mircotoll01/butterfly-SOA-driver/hardware/SOA-driver.kicad_pcb

## KiCad design hardware/SOA-driver.kicad_pcb (2025-08-11)

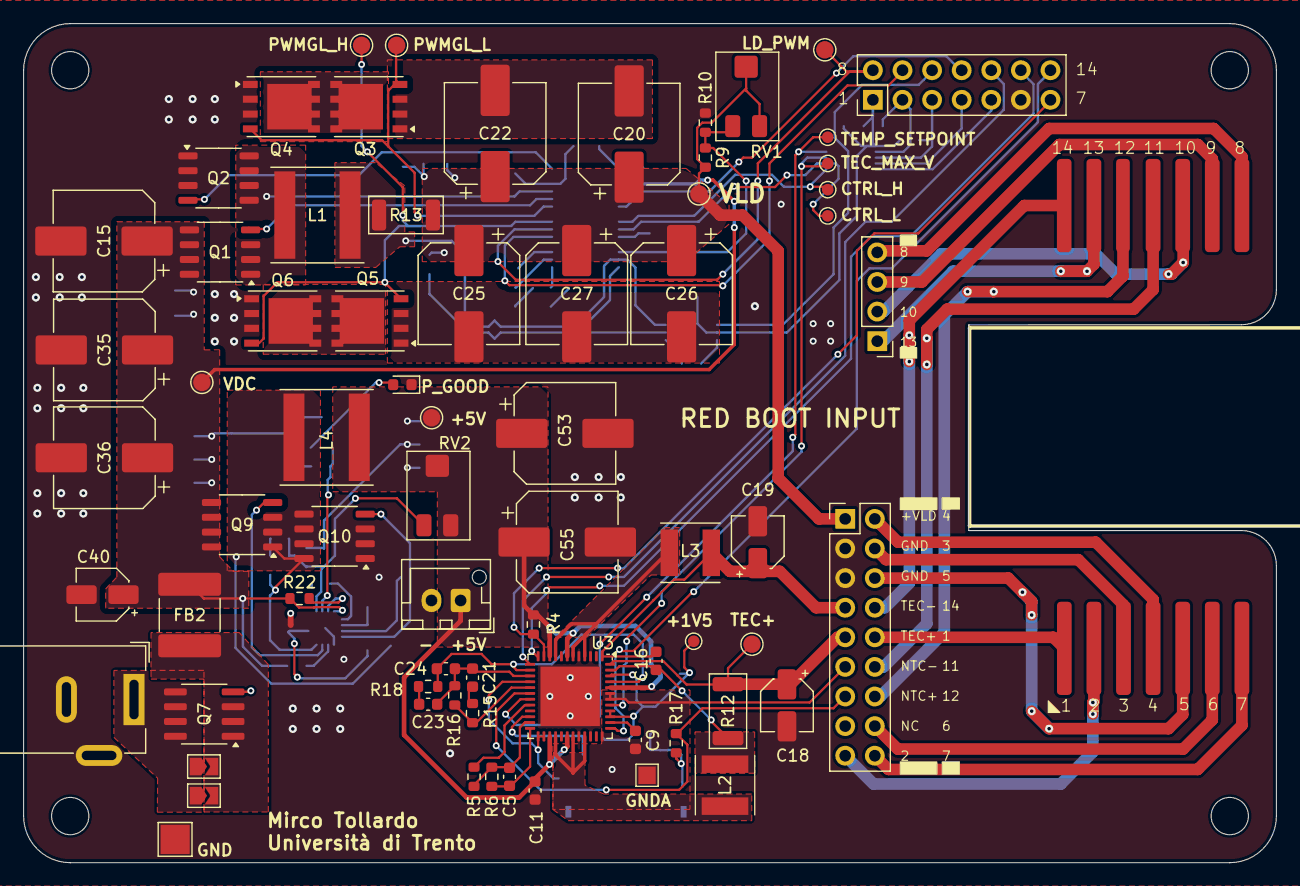
[picture p3: board SOA-driver.kicad_pcb from above]

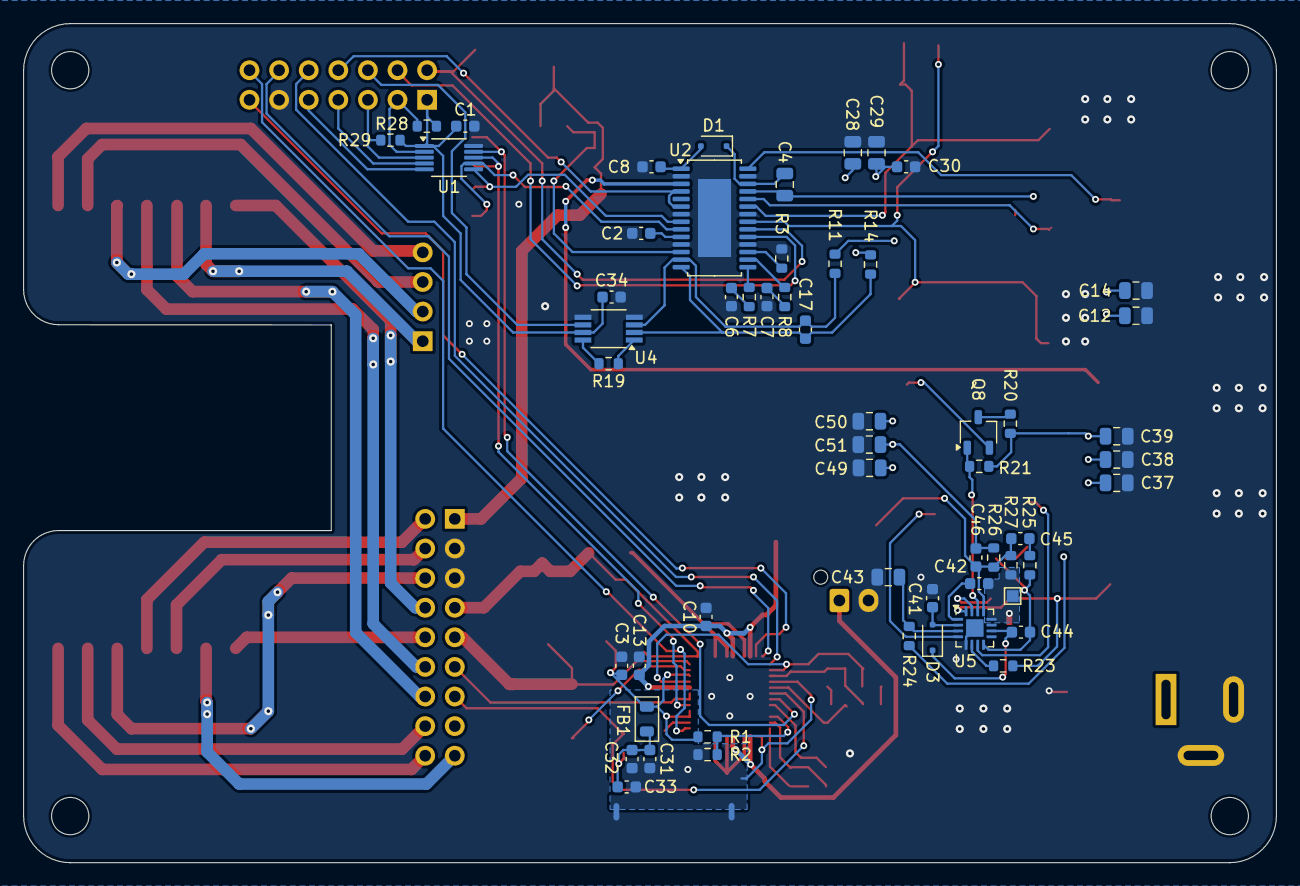
[picture p4: board SOA-driver.kicad_pcb from below]

Board: 2 copper layers, 107.5 x 72.0 mm, 136 parts (59 on the bottom side), 92 nets.

Parts:
C1, C3, C32, C34, C44, C45, C46: 100n; C_0603_1608Metric
C2, C9, C30, C33: 10n; C_0603_1608Metric
C4, C14, C29, C39, C43, C49: 100n; C_0805_2012Metric
C5, C31: 1u; C_0603_1608Metric
C6, C7: 2.2n; C_0603_1608Metric
C8, C10: 22u; C_0603_1608Metric
C11, C13, C23: 10u; C_0603_1608Metric
C12, C28, C38, C50: 1u; C_0805_2012Metric
C15, C20, C22, C25, C26, C27, C53, C55: 330u; CP_Elec_8x10.5
C16, C41, C42: 4u7; C_0603_1608Metric
C17: 33n; C_0603_1608Metric
C18, C19, C40: 1u; CP_Elec_4x5.4
C21, C24: 470n; C_0603_1608Metric
C35, C36: 220u; CP_Elec_8x10.5
C37, C51: 10u; C_0805_2012Metric
D1, D3: BAT54; D_SOD-323F
D2: LED; LED_0603_1608Metric
FB1: 110R; Ferrite_0805_2012Metric
FB2: 100; C_2220_5750Metric_Pad1.97x5.40mm_HandSolder
H1, H2, H3, H4: MountingHole; MountingHole_3.2mm_M3_ISO7380
J1: BASYS3; PinHeader_2x07_P2.54mm_Vertical
J2: BUTTERFLY; Butterfly_14pins_SMD
J3: Barrel_Jack_Switch; BarrelJack_Wuerth_6941xx301002
J4: SELECTOR; PinHeader_2x09_P2.54mm_Vertical
J5: SELECTOR_2; PinHeader_1x04_P2.54mm_Vertical
J6: 5V EXT; JST_XH_B2B-XH-AM_1x02_P2.50mm_Vertical
JP1, JP2: SolderJumper_2_Open; SolderJumper-2_P1.3mm_Open_TrianglePad1.0x1.5mm
L1, L4: 22u; L_Taiyo-Yuden_NR-80xx
L2, L3: 3u3; L_Taiyo-Yuden_NR-50xx
NT1, NT2, NT3: NetTie_2; NetTie-2_SMD_Pad0.5mm
Q1, Q2, Q9, Q10: RJK0355DSP; SOP-8_3.9x4.9mm_P1.27mm
Q3, Q4, Q5, Q6: SiRC18DP; PowerPAK_SO-8_Single
Q7: DMP3037LSS-13; SOIC-8_3.9x4.9mm_P1.27mm
Q8: 2N7002; TSOT-23
R1: 69.8k; R_0603_1608Metric
R2, R5: 20k; R_0603_1608Metric
R3: 40.2k; R_0603_1608Metric
R4, R10, R27, R29: 1k; R_0603_1608Metric
R6: 80.6k; R_0603_1608Metric
R7, R8: 806k; R_0603_1608Metric
R9, R20: 2k2; R_0603_1608Metric
R11, R14, R28: 10; R_0603_1608Metric
R12: 200m; R_2010_5025Metric
R13: 50m; R_2010_5025Metric
R15: 22k; R_0603_1608Metric
R16: 1M; R_0603_1608Metric
R17, R21, R22: 10k; R_0603_1608Metric
R18: 100k; R_0603_1608Metric
R19: 11K 0.1%; R_0603_1608Metric
R23: 100k 1%; R_0603_1608Metric
R24, R25: R_Small; R_0603_1608Metric
R26: 5k6; R_0603_1608Metric
RV1: 1k; Potentiometer_Bourns_3224X_Vertical
RV2: 10k; Potentiometer_Bourns_3224X_Vertical
TP1, TP8, TP9, TP10, TP11: TestPoint; TestPoint_Pad_D1.0mm
TP2: TestPoint; TestPoint_Pad_1.5x1.5mm
TP3, TP4, TP5, TP6, TP7, TP14, TP15: TestPoint; TestPoint_Pad_D1.5mm
TP12: TestPoint; TestPoint_Pad_2.5x2.5mm
TP13: TestPoint; TestPoint_Pad_1.0x1.0mm
U1: MCP4728; MSOP-10_3x3mm_P0.5mm
U2: LT3743; TSSOP-28-1EP_4.4x9.7mm_P0.65mm_EP2.85x6.7mm
U3: MAX1978; TQFN-48-1EP_7x7mm_P0.5mm_EP5.1x5.1mm
U4: INA333xxDGK; VSSOP-8_3.0x3.0mm_P0.65mm
U5: MIC2101; HVQFN-16-1EP_3x3mm_P0.5mm_EP1.5x1.5mm

Connections:
+1V5: C3.2, FB1.1, R1.1, TP1.1, U3.39 (MAXIP), U3.40 (MAXIN), U3.46 (REF)
+3V3: C1.1, C34.1, J1.1, R28.2, R29.2, U1.1 (VDD), U4.7 (V+)
+5V: C10.1, C11.1, C13.1, C46.2, C49.1, C50.1, C51.1, C53.1, C55.1, J6.1, L4.2, R4.1, R26.2, RV2.2, RV2.3, TP14.1, U3.7 (PVDD2), U3.10 (PVDD2), U3.27 (PVDD1), U3.30 (PVDD1), U3.44 (VDD)
/5V DCDC converter/DH: Q9.4 (G), U5.7 (DH)
/5V DCDC converter/DL: Q10.4 (G), U5.4 (DL)
/5V DCDC converter/FB: C45.1, C46.1, R26.1, R27.2, RV2.1, U5.13 (FB)
/SOA Driver/LD: C20.1, C22.1, C25.1, C26.1, C27.1, C28.1, C29.1, C30.1, J4.1, R9.2, R13.2, R14.2, RV1.2, RV1.3, TP4.1
/SOA Driver/NTC+: J4.13, R17.2, U3.18 (FB-)
/SOA Driver/PWMGH: Q5.4 (G), Q6.4 (G), TP5.1, U2.21 (PWMGH)
/SOA Driver/PWMGL: Q3.4 (G), Q4.4 (G), TP6.1, U2.23 (PWMGL)
/SOA Driver/Pin_1: J2.1, J4.10
/SOA Driver/Pin_2: J2.2, J4.17
/SOA Driver/Pin_3: J2.3, J4.4
/SOA Driver/Pin_4: J2.4, J4.2
/SOA Driver/Pin_5: J2.5, J4.6
/SOA Driver/Pin_6: J2.6, J4.16
/SOA Driver/Pin_7: J2.7, J4.18
/SOA Driver/Pin_8: J2.8, J5.4
/SOA Driver/Pin_9: J2.9, J5.3
/SOA Driver/Pin_10: J2.10, J5.2
/SOA Driver/Pin_11: J2.11, J4.12
/SOA Driver/Pin_12: J2.12, J4.14
/SOA Driver/Pin_13: J2.13, J5.1
/SOA Driver/Pin_14: J2.14, J4.8
/SOA Driver/SENSE+: C17.2, R11.1, U2.13 (SENSE+), U4.3 (+)
/SOA Driver/SENSE-: C17.1, R14.1, U2.14 (SENSE-), U4.2 (-)
/SOA Driver/SW: C4.2, L1.1, Q1.1 (S), Q1.2 (S), Q1.3 (S), Q2.5 (D), Q2.6 (D), Q2.7 (D), Q2.8 (D), U2.25 (SW)
/SOA Driver/TEC+: C18.1, J4.9, R12.2, TP3.1, U3.48 (OS1)
/SOA Driver/TEC-: C16.2, C19.1, J4.7, L3.2, U3.1 (OS2)
/TEC controller/1V5ADC: C31.1, C32.1, C33.1, FB1.2, R17.1
/TEC controller/BFB-: R5.2, U3.20 (BFB-)
/TEC controller/INT-: C21.1, C23.2, C24.1, R16.2, U3.15 (INT-)
/TEC controller/INTOUT: C24.2, R18.1, U3.14 (INTOUT), U3.45 (CTLI)
/TEC controller/MAXV_DAC: TP10.1, U1.8 (VOUTC), U3.41 (MAXV)
/TEC controller/TTEC_SETPOINT_DAC: TP11.1, U1.9 (VOUTD), U3.19 (FB+)
CTRL_H_DAC: TP8.1, U1.6 (VOUTA), U2.8 (CTRL_H)
CTRL_L_DAC: TP9.1, U1.7 (VOUTB), U2.9 (CTRL_L)
GND: C1.2, C2.1, C3.1, C6.2, C7.1, C8.1, C10.2, C11.2, C12.2, C13.2, C14.2, C15.2, C18.2, C19.2, C28.2, C29.2, C30.2, C34.2, C35.2, C36.2, C37.2, C38.2, C39.2, C40.2, C41.2, C43.1, C49.2, C50.2, C51.2, C53.2, C55.2, D2.1 (K), J1.11, J3.2, J3.3, J4.3, J4.5, J6.2, NT1.1, NT2.1, NT3.1, Q2.1 (S), Q2.2 (S), Q2.3 (S), Q4.1 (S), Q4.2 (S), Q4.3 (S), Q6.1 (S), Q6.2 (S), Q6.3 (S), Q7.4 (G), Q10.1 (S), Q10.2 (S), Q10.3 (S), R3.1, R10.1, TP12.1, U1.10 (VSS), U2.2 (GND), U2.7 (GND), U2.11 (GND), U2.18 (SYNC), U2.22 (GND), U2.27 (GND), U2.29 (GND), U3.3 (PGND2), U3.5 (PGND2), U3.32 (PGND1), U3.34 (PGND1), U3.49 (EP), U4.4 (V-), U4.5 (Ref), U5.5 (PGND), U5.17 (EP)
GND1: C42.2, NT2.2, R27.1, TP13.1, U5.12 (AGND)
GNDA: C9.2, C31.2, C32.2, C33.2, NT1.2, NT3.2, R2.2, TP2.1, U3.16 (AGND), U3.25 (AGND), U3.26 (AGND), U3.36 (FREQ), U3.42 (AGND), U3.43 (AGND)
ILD_MON: J1.6, U4.6
ITEC_MON: J1.14, U3.37 (ITEC)
LD_EN: J1.8, U2.4 (EN/UVLO), U2.6 (CTRL_T)
LD_MODULATION: TP7.1, U2.20 (PWM)
unnamed: C6.1, R7.2
unnamed: C7.2, R8.2
unnamed: C20.2, C22.2, Q3.1 (S), Q3.2 (S), Q3.3 (S)
unnamed: C21.2, R15.2
unnamed: C23.1, R18.2
unnamed: C25.2, C26.2, C27.2, Q5.1 (S), Q5.2 (S), Q5.3 (S)
unnamed: C45.2, R25.1
unnamed: C8.2, D1.2 (A), U2.1 (VCC_INT)
unnamed: C4.1, D1.1 (K), U2.26 (CBOOT)
unnamed: D2.2 (A), Q8.2 (S)
unnamed: C41.1, C42.1, D3.2 (A), U5.1 (VDD), U5.2 (PVDD)
unnamed: C44.2, D3.1 (K), U5.10 (BST)
unnamed: J3.1, JP1.1 (A), JP2.1 (A), Q7.5 (D), Q7.6 (D), Q7.7 (D), Q7.8 (D)
unnamed: FB2.1, JP1.2 (B), JP2.2 (B), Q7.1 (S), Q7.2 (S), Q7.3 (S)
unnamed: L1.2, R11.2, R13.1
unnamed: L2.1, U3.28 (LX1), U3.31 (LX1), U3.33 (LX1)
unnamed: L3.1, U3.4 (LX2), U3.6 (LX2), U3.9 (LX2)
unnamed: Q1.4 (G), U2.24 (HG)
unnamed: Q2.4 (G), U2.28 (LG)
unnamed: Q3.5 (D), Q4.5 (D)
unnamed: Q5.5 (D), Q6.5 (D)
unnamed: Q8.3 (D), R20.1
unnamed: Q8.1 (G), R21.1, U5.14 (PG)
unnamed: R19.1, U4.8 (Rg)
unnamed: R19.2, U4.1 (Rg)
unnamed: R9.1, R10.2, RV1.1, U2.12 (FB)
unnamed: R3.2, U2.17 (RT)
unnamed: C2.2, U2.10 (SS)
unnamed: R8.1, U2.16 (VCH)
unnamed: R7.1, U2.15 (VCL)
unnamed: R1.2, R2.1, U3.22 (AIN+)
unnamed: C5.1, R5.1, R6.1, U3.23 (AIN-)
unnamed: C5.2, R6.2, U3.24 (AOUT)
unnamed: C9.1, U3.38 (COMP)
unnamed: C16.1, L2.2, R12.1, U3.47 (CS)
unnamed: R15.1, R16.1, U3.17 (DIFOUT)
unnamed: R22.1, U5.15 (EN)
unnamed: R23.1, U5.6 (FREQ)
unnamed: C43.2, R24.1, U5.3 (ILIM)
unnamed: C44.1, L4.1, Q9.1 (S), Q9.2 (S), Q9.3 (S), Q10.5 (D), Q10.6 (D), Q10.7 (D), Q10.8 (D), R24.2, R25.2, U5.8 (SW)
OVERTMP_ALM: J1.12, U3.12 (~OT)
RDY/~BSY: J1.9, U1.5 (RDY/~BSY)
SCL: J1.3, R28.1, U1.2 (SCL)
SDA: J1.5, R29.1, U1.3 (SDA)
TEC_~SHD: R4.2, U3.11 (~SHD)
UNDERTMP_ALM: J1.10, U3.13 (~UT)
VDC: C12.1, C14.1, C15.1, C35.1, C36.1, C37.1, C38.1, C39.1, C40.1, FB2.2, Q1.5 (D), Q1.6 (D), Q1.7 (D), Q1.8 (D), Q9.5 (D), Q9.6 (D), Q9.7 (D), Q9.8 (D), R20.2, R21.2, R22.2, R23.2, TP15.1, U2.3 (VIN), U5.16 (VIN)
~LDAC: J1.7, U1.4 (~LDAC)
