mircotoll01/butterfly-SOA-driver/firmware/src/Control_Unit.vhd

library IEEE;
use IEEE.STD_LOGIC_1164.ALL;

entity Control_Unit is
    Port (
        --Inputs
        reset               : in std_logic;
        clk                 : in std_logic;
        uart_rx             : in std_logic;
        overtemp_alarm      : in std_logic;
        undertemp_alarm     : in std_logic;
        
        --JXADC channel 15
        vauxp15             : in std_logic;
        vauxn15             : in std_logic;
                
        --Outputs
        sda                 : inout std_logic;
        scl                 : inout std_logic;
        n_ldac              : out std_logic;
        ctrl_sel_pwm        : out std_logic;
        soa_pwm             : out std_logic;
        soa_en              : out std_logic;
        tec_en              : out std_logic;
        seg                 : out std_logic_vector(5 downto 0);
        an                  : out std_logic_vector(3 downto 0);
        uart_tx             : out std_logic
    );
end Control_Unit;

architecture Structural of Control_Unit is

    -- signals to interconnect i2c master and paload generation
    signal payload          : std_logic_vector(71 downto 0);
    signal clk_div          : std_logic;        
    
    -- signals for mudulation and controls
    signal mod_status       : std_logic_vector(1 downto 0);
    signal soa_tec_status   : std_logic_vector(1 downto 0);
    signal ctrl_l           : integer;
    signal ctrl_h           : integer;
    signal setpoint         : integer;
    signal tec_maxv         : integer;
    signal duty_cycle       : integer;
    
    -- signals for the ADC
    signal SOA_current_dig  : std_logic_vector(15 downto 0);
    signal channel_out      : std_logic_vector(4 downto 0);
    signal adc_eoc          : std_logic;
    signal adc_rdy          : std_logic;
    signal adc_off          : std_logic;
    
    component clk_divider
        Port(
            clk             : in std_logic;
            clk_div         : out std_logic
        );
    end component;
    
    -- components for I2C communication
    component MCP4728_payload_generator
        Port ( 
            ctrl_h          : in integer;  
            ctrl_l          : in integer;
            tec_maxv        : in integer;
            setpoint        : in integer;
            I2C_payload     : out std_logic_vector(71 downto 0)
        );
    end component;
    
    component I2C_Master
        Port (
            clk             : in std_logic;
            reset           : in  std_logic;
            I2C_payload     : in  std_logic_vector(71 downto 0);  
            sda             : inout std_logic;
            scl             : inout std_logic;
            n_ldac          : out std_logic
        );
    end component;
    
    -- components for SOA drive
    component modulator
        Port (
            clk             : in std_logic;
            overtemp_alarm  : in std_logic;
            undertemp_alarm : in std_logic;
            duty_cycle      : in integer;
            mod_status_in   : in std_logic_vector(1 downto 0);
            soa_tec_status  : in std_logic_vector(1 downto 0);
            soa_en          : out std_logic;
            tec_en          : out std_logic;
            ctrl_sel        : out std_logic;
            pwm             : out std_logic
        );
    end component;
    
    component Display
        Port(
            clk             : in std_logic;
            mode            : in std_logic_vector(1 downto 0);
            status          : in std_logic_vector(1 downto 0);
            seg             : out std_logic_vector(5 downto 0);
            an              : out std_logic_vector(3 downto 0)
        );
    end component;
    
    -- component for UART communication
    component UART_transceiver
        Port (
            clk             : in std_logic;
            reset           : in std_logic;
            adc_read        : in std_logic_vector(15 downto 0);
            adc_rdy         : in std_logic;
            uart_rx         : in std_logic;
            
            uart_tx         : out std_logic;
            duty_cycle      : out integer;  
            ctrl_l          : out integer; 
            ctrl_h          : out integer; 
            tec_maxv        : out integer;  
            setpoint        : out integer;                      
            mod_status      : out std_logic_vector(1 downto 0);
            soa_tec_status  : out std_logic_vector(1 downto 0)
        );               
    end component;
    
    component xadc_wiz_0
        Port(
            dclk_in         : in std_logic;                         
            reset_in        : in std_logic;   
            daddr_in        : in std_logic_vector(6 downto 0);     
            den_in          : in std_logic;                         
            di_in           : in std_logic_vector(15 downto 0);    
            dwe_in          : in std_logic;                                      
            vauxp15         : in std_logic;                       
            vauxn15         : in std_logic;
            vp_in           : in std_logic;                      
            vn_in           : in std_logic;
            
            busy_out        : out std_logic;                        
            drdy_out        : out std_logic;
            eoc_out         : out std_logic;                        
            eos_out         : out std_logic;                        
            alarm_out       : out std_logic;                        
            do_out          : out std_logic_vector(15 downto 0);   
            channel_out     : out std_logic_vector(4 downto 0)  
        );
    end component;
    
begin
    div : clk_divider
        Port map(
            clk             => clk,
            clk_div         => clk_div
        );
        
    -- uart communication block
    transceiver : UART_transceiver
        Port map(
            clk             => clk_div,
            reset           => reset,
            adc_read        => SOA_current_dig,
            adc_rdy         => adc_eoc and adc_rdy,
            uart_rx         => uart_rx,
            uart_tx         => uart_tx,
            duty_cycle      => duty_cycle,  
            ctrl_l          => ctrl_l,
            ctrl_h          => ctrl_h,
            tec_maxv        => tec_maxv,
            setpoint        => setpoint,                                  
            mod_status      => mod_status,
            soa_tec_status  => soa_tec_status
        );
        
    -- modulation and control block
    modulator_block : modulator
        Port map (
            clk             => clk_div,
            overtemp_alarm  => overtemp_alarm,
            undertemp_alarm => undertemp_alarm,
            duty_cycle      => duty_cycle,
            mod_status_in   => mod_status,
            soa_en          => soa_en,
            tec_en          => tec_en,
            soa_tec_status  => soa_tec_status, 
            ctrl_sel        => ctrl_sel_pwm,
            pwm             => soa_pwm
        );

    display_block : Display
        Port map(
            clk             => clk_div,
            mode            => mod_status,
            status          => soa_tec_status,
            seg             => seg,
            an              => an
        );
        
    i2c_gen: MCP4728_payload_generator
        Port map (
            ctrl_l          => ctrl_l,
            ctrl_h          => ctrl_h,
            tec_maxv        => tec_maxv,
            setpoint        => setpoint,
            I2C_payload     => payload  
        );
        
    i2cmaster : I2C_Master
        Port map (
            clk             => clk_div,
            reset           => reset,
            I2C_payload     => payload,
            sda             => sda,
            scl             => scl,
            n_ldac          => n_ldac
        );
    
    ADC : xadc_wiz_0
        Port map(
            dclk_in         => clk_div,
            reset_in        => reset,
            daddr_in        => "0011111",
            den_in          => '1',
            di_in           => (others => '0'),
            dwe_in          => '0',
            vauxp15         => vauxp15,                      
            vauxn15         => vauxn15,
            vp_in           => '0',                
            vn_in           => '0',
            
            drdy_out        => adc_rdy,
            eoc_out         => adc_eoc,
            eos_out         => open,
            busy_out        => open,
            alarm_out       => open,                    
            do_out          => SOA_current_dig,
            channel_out     => open
        );
end Structural;
