mircotoll01/butterfly-SOA-driver/firmware/src/UART_parser.vhd

library IEEE;
use IEEE.STD_LOGIC_1164.ALL;
use IEEE.NUMERIC_STD.ALL;
library xil_defaultlib;
use xil_defaultlib.utils_pkg.all;

entity UART_parser is
    Port ( 
        clk                 : in std_logic;
        data_ready_in       : in std_logic;
        uart_byte_in        : in std_logic_vector(7 downto 0);
        command_parsed_out  : out std_logic_vector(23 downto 0);
        attribute_ASCII_out : out std_logic_vector(31 downto 0);
        ctl_value_ASCII_out : out std_logic_vector(31 downto 0);
        ctrl_l              : out integer;
        ctrl_h              : out integer;
        tec_maxv            : out integer;
        setpoint            : out integer;
        duty_cycle          : out integer;
        mod_status_out      : out std_logic_vector(1 downto 0);
        soa_tec_status      : out std_logic_vector(1 downto 0)
    );
end UART_parser;

architecture Behavioral of UART_parser is
    signal char_index           : integer range 0 to 13 := 0;
    signal command_reg          : ASCII_string := (others => (others => '0'));
    signal command_buffer       : ASCII_string := (others => (others => '0'));
    signal command_parsed       : std_logic_vector(23 downto 0) := (others => '0');
    signal attribute_ASCII      : std_logic_vector(31 downto 0) := (others => '0');
    signal pwm_value_ASCII      : std_logic_vector(23 downto 0) := (others => '0');
    signal ctl_value_ASCII      : std_logic_vector(31 downto 0) := (others => '0');
    signal data_ready_prev      : std_logic := '0';
    
    signal ctrl_l_reg           : integer := 0;
    signal ctrl_h_reg           : integer := 0;
    signal tec_maxv_reg         : integer := 0;
    signal setpoint_reg         : integer := 0;
    signal duty_cycle_reg       : integer := 0;
    signal mod_status_reg       : std_logic_vector(1 downto 0) := "00";
    signal soa_tec_status_reg   : std_logic_vector(1 downto 0) := "00";
begin
    
    process(clk)
    begin
        if rising_edge(clk) then
            data_ready_prev     <= data_ready_in;
            if (data_ready_in = '1' and data_ready_prev = '0') then
                command_buffer(char_index)      <= uart_byte_in;
                char_index                      <= char_index + 1;
                if uart_byte_in = x"0A" then                                       -- When \n is given (line feed is number 10 in ascii code), analyze the command
                    char_index                      <= 0;
                    command_parsed                  <= command_buffer(0) & 
                                                        command_buffer(1) &
                                                        command_buffer(2); 
                                               
                    attribute_ASCII                 <= command_buffer(4) &
                                                        command_buffer(5) &
                                                        command_buffer(6) &
                                                        command_buffer(7);  
                                               
                    ctl_value_ASCII                 <= command_buffer(9) &
                                                        command_buffer(10) &
                                                        command_buffer(11) &
                                                        command_buffer(12);
                                                        
                    command_buffer                  <= (others => (others => '0'));
                end if;
            end if;
            
            case command_parsed is
                when x"4F4646" | x"6F6666" => -- ASCII code for OFF
                    mod_status_reg       <= "00";
                    soa_tec_status_reg   <= "00";
                when x"50574D" | x"70776D" => -- ASCII coded for PWM This command expects an integer value for duty cycle from 0 to 99
                    mod_status_reg          <= "01";
                    if ascii_to_integer(attribute_ASCII(31 downto 8)) > 100 then
                        duty_cycle_reg      <= 100;
                    else
                        duty_cycle_reg      <= ascii_to_integer(attribute_ASCII(31 downto 8));
                    end if;
                when x"44424C" | x"64626C" => -- ASCII coded for DBL This command expects two integer values for dac from 0 to 2048
                    mod_status_reg         <= "10";
                    if ascii_to_integer(attribute_ASCII(31 downto 8)) > 100 then
                        duty_cycle_reg      <= 100;
                    else
                        duty_cycle_reg      <= ascii_to_integer(attribute_ASCII(31 downto 8));
                    end if;
                when x"544543" | x"746563" => -- ASCII code for TEC
                    if attribute_ASCII(31 downto 16) = x"4F4E" or attribute_ASCII(31 downto 16) = x"6F6E" then -- ON
                        soa_tec_status_reg(0)      <= '1';
                    elsif attribute_ASCII(31 downto 8) = x"4F4646"  or attribute_ASCII(31 downto 8) = x"6F6666" then -- OFF
                        soa_tec_status_reg(0)      <= '0';
                    end if;
                    
                when x"434343" | x"636363" => -- ASCII code for CCC (Constant Current Control)
                    if attribute_ASCII(31 downto 16) = x"4F4E" or attribute_ASCII(31 downto 16) = x"6F6E" then -- ON
                        soa_tec_status_reg(1)      <= '1';
                    elsif attribute_ASCII(31 downto 8) = x"4F4646"  or attribute_ASCII(31 downto 8) = x"6F6666" then -- OFF
                        soa_tec_status_reg(1)      <= '0';
                    end if;
                    
                when x"534554" | x"736574" => -- ASCII coded for SET
                    case attribute_ASCII is 
                        when x"43544C4C" | x"63746C6C" => -- CTLL changes CTRL_L
                            if four_bytes_ascii_to_integer(ctl_value_ASCII) >= 1500 then -- CTRL range 0 to 1.5V
                                ctrl_l_reg          <= 1500;
                            else
                                ctrl_l_reg          <= four_bytes_ascii_to_integer(ctl_value_ASCII);
                            end if;
                        when x"43544C48" | x"63746C68" => -- CTLH changes CTRL_H
                            if four_bytes_ascii_to_integer(ctl_value_ASCII) > 1500 then
                                ctrl_h_reg          <= 1500;
                            else
                                ctrl_h_reg          <= four_bytes_ascii_to_integer(ctl_value_ASCII);
                            end if;
                        when x"4D415856" | x"6D617876" => -- MAXV changes maximum tec voltage
                            if four_bytes_ascii_to_integer(ctl_value_ASCII) > 5000 then   -- TEC voltage is 4*VMAXV, hence maximum voltage has to be 1,25V to achieve 0-5V range
                                tec_maxv_reg        <= 5000;                              -- for this reason the value will be divided by 4 later
                            else
                                tec_maxv_reg        <= four_bytes_ascii_to_integer(ctl_value_ASCII);
                            end if;
                        when x"54534554" | x"74736574" => -- TSET changes temperature setpoint for TEC controller
                            if four_bytes_ascii_to_integer(ctl_value_ASCII) > 1500 then -- NTC is in a 1.5V VCC voltage divider
                                setpoint_reg        <= 1500;
                            else
                                setpoint_reg        <= four_bytes_ascii_to_integer(ctl_value_ASCII);
                            end if;
                        when others =>
                    end case;
                when others =>
            end case;
        end if;
    end process;
    
    command_parsed_out      <= command_parsed;
    attribute_ASCII_out     <= attribute_ASCII;
    ctl_value_ASCII_out     <= ctl_value_ASCII;
    
    ctrl_l                  <= ctrl_l_reg;
    ctrl_h                  <= ctrl_h_reg;
    tec_maxv                <= tec_maxv_reg; 
    setpoint                <= setpoint_reg;
    duty_cycle              <= duty_cycle_reg; 
    mod_status_out          <= mod_status_reg;
    soa_tec_status          <= soa_tec_status_reg;
end Behavioral;
