mircotoll01/butterfly-SOA-driver/(commit log)

2024-04-15 Uploaded a slave module to drive a generic LD
    [LD-Driver.kicad_pcb, LD-Driver.kicad_sch, driver.kicad_sch, power.kicad_sch]
2024-04-17 small schematic correction, structural changes to the 5V buck on the pcb
    [LD-Driver.kicad_pcb, power.kicad_sch]
2024-04-30 update PCB: fixed buck layout, concept layout for LD driver with LT3743
    [LD-Driver.kicad_pcb, LD-Driver.kicad_sch, driver.kicad_sch, power.kicad_sch]
2024-05-08 Changed overall subsystem positions, TEC controller implemented, LD controller IC position to be reconsidered in order to have enough clearance after header connector is fully routed
    [LD-Driver.kicad_pcb, driver.kicad_sch, power.kicad_sch]
2024-05-16 PCB routing completed, started uniforming components for smaller BOM
    [LD-Driver.kicad_pcb, LD-Driver.kicad_sch, driver.kicad_sch, power.kicad_sch]
2024-05-16 small corrections to PCB, fixed some capacitors' voltage ratings and footprints to make BOM more uniform
    [LD-Driver.kicad_pcb, driver.kicad_sch, power.kicad_sch]
2024-05-16 small fixes to PCB and silkscreen
    [LD-Driver.kicad_pcb]
2024-05-28 feat: made possible to swap butterfly pins for compatibility
    [LD-Driver.kicad_pcb, LD-Driver.kicad_sch, driver.kicad_sch, power.kicad_sch]
2024-05-31 feat: added method to swap butterfly socket pins to adapt to multiple SOA SNs. Fixed routing imperfections and addes informative silkscreen
    [LD-Driver.kicad_pcb, driver.kicad_sch]
2024-06-24 fix: small corrections to the pcb, added PNs and store link to mouser for each component
    [LD-Driver.kicad_pcb, LD-Driver.kicad_sch, driver.kicad_sch, power.kicad_sch]
2024-12-04 fix: shorted PVDD and VDD on MIC
    [LD-Driver.kicad_pcb, LD-Driver.kicad_sch, driver.kicad_sch, power.kicad_sch]
2024-12-04 feat: added firmware and better dir management, updates gitignore for vivado files
    [SOA-driver.kicad_pcb, SOA-driver.kicad_sch, driver.kicad_sch, power.kicad_sch]
2024-12-10 feat: payload generation for I2C master
2024-12-10 fix: tidier schematic
    [SOA-driver.kicad_pcb, SOA-driver.kicad_sch, driver.kicad_sch, external.kicad_sch, power.kicad_sch, tec-controller.kicad_sch]
2024-12-12 feat: added UART communication block to set SOA driving parameters
    [power.kicad_sch]
2024-12-14 feat: dedicated UART parser, receiver now uses structural code. Control Unit now synthetizable
2024-12-18 fix: code synthetizable, partially fixed structure not synthetizing correctly
    [Basys3_Master.xdc, Control_Unit.vhd, Display.vhd, I2C-master.vhd, Modulator.vhd, Payload-gen.vhd, UART-receiver.vhd, UART_parser.vhd]
2025-02-26 feat: UART communication working, now with transmitter to verify that the sent packet is correct
    [SOA-driver.kicad_sch, driver.kicad_sch, external.kicad_sch, power.kicad_sch, tec-controller.kicad_sch]
2025-03-04 fix: timing fixed by lowering system clock to 10MHz, minor fixes to code
    [Basys3_Master.xdc, Control_Unit.vhd, Display.vhd, I2C-master.vhd, Modulator.vhd, Payload-gen.vhd, UART-receiver.vhd, UART_parser.vhd]
2025-03-15 fix: PWM mode now accepting values from 000 to 100
    [Basys3_Master.xdc, UART_parser.vhd]
2025-03-15 feat: decent readme as user manual
    [SOA-driver.kicad_pcb, external.kicad_sch]
2025-03-17 feat: added limitations in input integers in parser, minor fixes to readme
    [UART_parser.vhd]
2025-05-19 feat: SPI monitor in python, UART transmission for ADC reading (untested)
2025-06-04 feat: new graphic interface to see currently stored values in driver's register, full bidirectional UART communication
2025-06-04 fix: minor fixes to modulator
    [Control_Unit.vhd, I2C-master.vhd, Modulator.vhd, UART_parser.vhd]
2025-06-05 feat: parser with cleaner code and case insensitive, minor fixes to code
    [Basys3_Master.xdc, Control_Unit.vhd, Modulator.vhd, UART-receiver.vhd, UART_parser.vhd, UART_transmitter.vhd, clk_divider.vhd]
2025-06-06 fix: maajor fixes to code, partial simulation of control unit to check if modulation is working correctly
    [I2C-master.vhd, Modulator.vhd, Payload-gen.vhd, UART_transceiver.vhd, clk_divider.vhd]
2025-06-06 fix: parser properly tested, partially clock sensitive to avoid wrong synthesis, modulator set to lower switching frequencies
    [Modulator.vhd, UART-receiver.vhd, UART_parser.vhd, UART_transceiver.vhd, UART_transmitter.vhd]
2025-07-24 fix: I2C fixed and tested, modulation working with double threshold. feat: TEC and SOA can be enabled separately
    [external.kicad_sch]
2025-07-25 fix: ADC fully tested
    [Basys3_Master.xdc, Control_Unit.vhd, UART_payload_gen.vhd, UART_transceiver.vhd]
2025-08-11 feat: syntethizing parser with output registers instead on using external reg, minor fixes to schematic and PCB
    [SOA-driver.kicad_pcb, driver.kicad_sch, external.kicad_sch, power.kicad_sch, tec-controller.kicad_sch]
2025-08-12 feat: add coefficient calculations for tested QSOA-1550, minor fix to parser register
    [Control_Unit.vhd, I2C-master.vhd, SPI_CTRL.py, UART_parser.vhd, UART_payload_gen.vhd, UART_transceiver.vhd]
